marucome09/26Pto34P_relay/power_conn.jpg

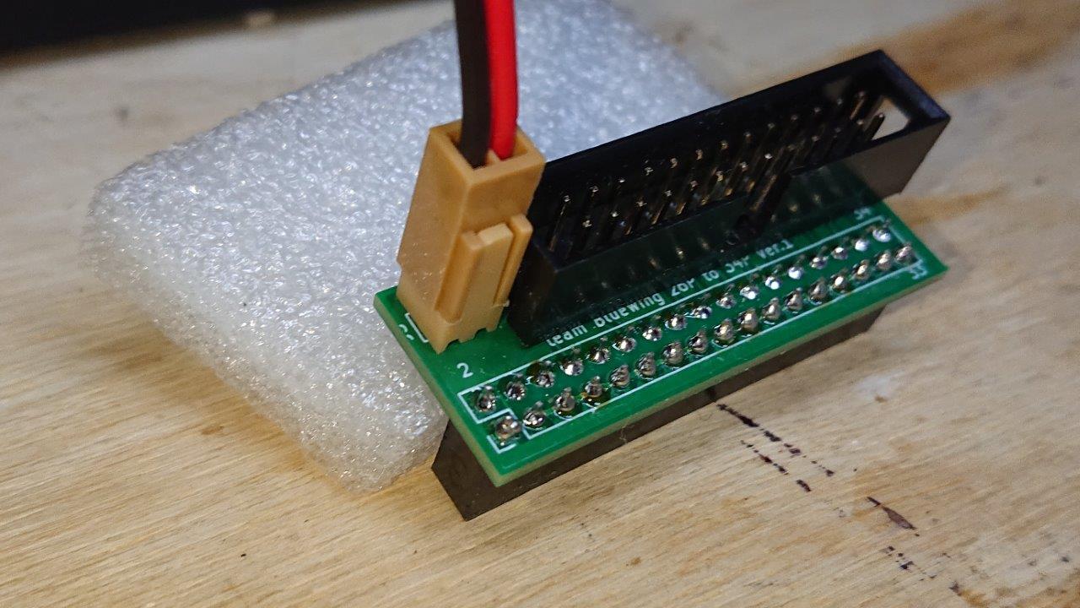
power_conn.jpg
