marucome09/26Pto34P_relay/kicad/fd_26_to_34.sch

## KiCad design kicad/fd_26_to_34.sch (2020-07-18)

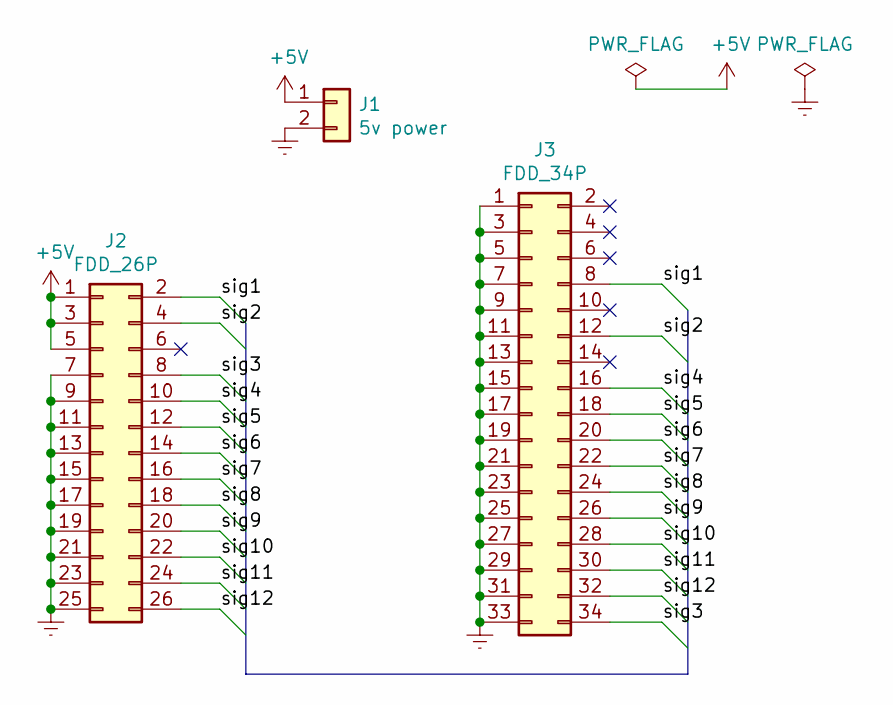
[picture p5: schematic fd_26_to_34.sch]

Parts:
J1: 5v power; PinHeader_1x02_P2.54mm_Vertical
J2: FDD_26P; PinHeader_2x13_P2.54mm_Vertical
J3: FDD_34P; PinHeader_2x17_P2.54mm_Vertical

Connections:
+5V: J1.1, J2.1, J2.3, J2.5
Earth: J1.2, J2.7, J2.9, J2.11, J2.13, J2.15, J2.17, J2.19, J2.21, J2.23, J2.25, J3.1, J3.3, J3.5, J3.7, J3.9, J3.11, J3.13, J3.15, J3.17, J3.19, J3.21, J3.23, J3.25, J3.27, J3.29, J3.31, J3.33
sig1: J2.2, J3.8
sig2: J2.4, J3.12
sig3: J2.8, J3.34
sig4: J2.10, J3.16
sig5: J2.12, J3.18
sig6: J2.14, J3.20
sig7: J2.16, J3.22
sig8: J2.18, J3.24
sig9: J2.20, J3.26
sig10: J2.22, J3.28
sig11: J2.24, J3.30
sig12: J2.26, J3.32
